macca448/Blynk2MESH/assets/blynk_pin_map.jpg

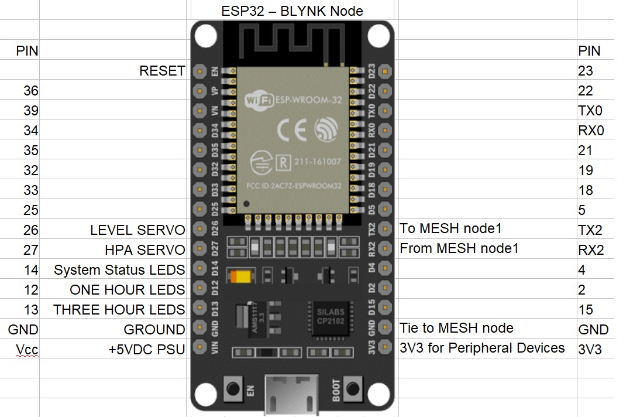
assets/blynk_pin_map.jpg
