macca448/Blynk2MESH/assets/garage_pin_map.jpg

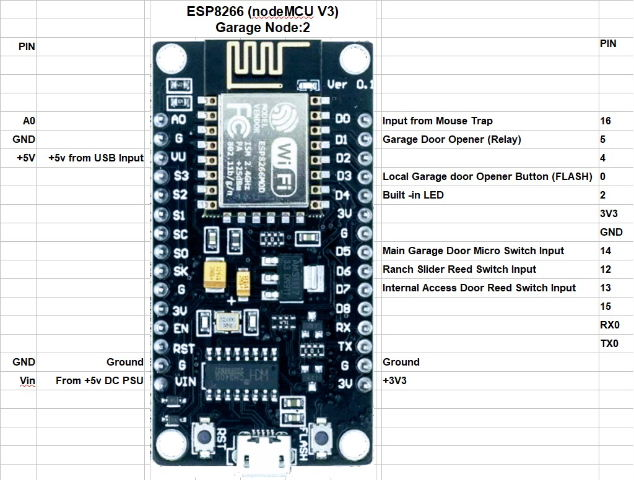
assets/garage_pin_map.jpg
