macca448/Blynk2MESH/assets/kitchen_pin_map.jpg

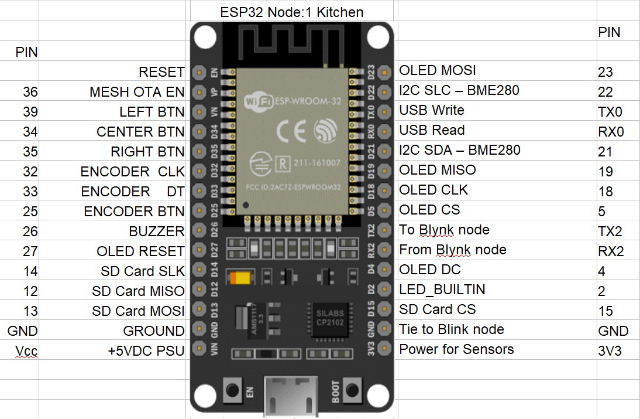
assets/kitchen_pin_map.jpg
