macca448/Blynk2MESH/assets/mouse_trap_circuit.png

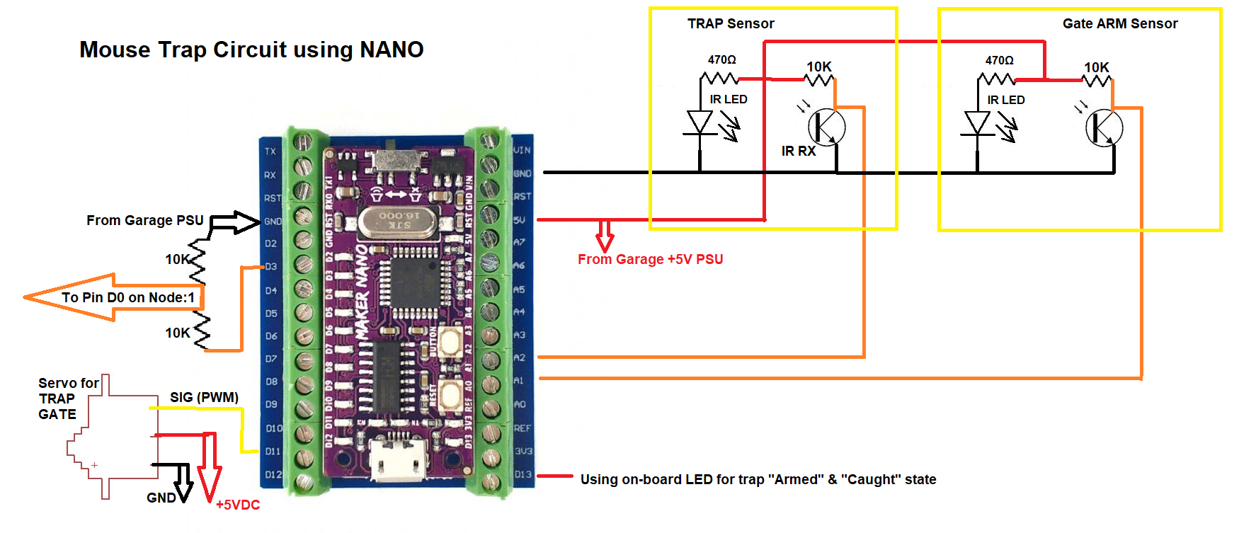
assets/mouse_trap_circuit.png
