macca448/Blynk2MESH/assets/bom_&_pin_assignments.xls

Sheet: BoM
BLYNK 2 MESH Bill-of-Materials (BoM)
Item | Part # | Qty | Description
1 | ESP32 | 3 | for Blynk, Node1 and Node4
2 | ESP8266 | 2 | Fo rNode 2 and 3
3 | PSU | 2 | 1A wall Wart for Nodes 2 and 3
4 | PSU | 2 | 2A Wall warts for Nodes1/Blynk and Node 4
5 | SSD1306 | 1 | 2.4” OLED
6 | Encoder | 1 | Rotary Encoder
7 | Buttons | 3 | Momentay Buttons
8 | Switch | 1 | Slide Switch
9 | Buzzer | 1 | Buzzer
10 | SD Card | 1 | SD card Reader
11 | BMP280 | 1 | BMP280 Sensor
12 | LED Strip | 3 | 8bit Addressable LED Strip
13 | Servo | 2 | Minature servo for analog gauges
14 | Relay | 1 | Relay Module for Garage door Open Close
15 | Micro Sw | 1 | Micro Switch for garage Door state
16 | REED Sw | 2 | magnetic Reed switches for Ranch and Internal Garage Doors
17 | NANO | 1 | For Mouse Trap
18 | IR Emitter | 2 | IR Emitters for Mouse Trap
19 | IR RX | 2 | Photodiodes for Mouse Trap
20 | Servo | 1 | Mouse Trap Gate Servo
21 | Combo | 1 | ATX and BMP Combo Weather Sensor for Tank1
22 | JSN-SR04T | 1 | Waterproof Ultrasonic Sensor
23 | DS18b20 | 1 | Waterproof Tank Temp Sensor
24 | Relay | 1 | Relay Module for Yard Lights
25 | Current1 | 2 | 30A Curent Transformer
26 | Current2 | 1 | 5A Current Transformer
27 | AC Mon | 1 | AC Voltage Detection Module
28 | Hi-Torque | 1 | 20Kg Hi-Torque Servo
29 | 10K | 12
30 | 470R | 2
31 | 4.7K | 2
32 | Misc |  | Wire, Vero boards, connectors etc for each node
33 | 3D |  | 3D Printed Gears, Mounts and LED difusers

Sheet: Blynk Kitchen
 |  | ESP32 – BLYNK Node
PIN |  |  |  | PIN
 | RESET |  |  | 23
36 |  |  |  | 22
39 |  |  |  | TX0
34 |  |  |  | RX0
35 |  |  |  | 21
32 |  |  |  | 19
33 |  |  |  | 18
25 |  |  |  | 5
26 | LEVEL SERVO |  | To MESH node1 | TX2
27 | HPA SERVO |  | From MESH node1 | RX2
14 | System Status LEDS |  |  | 4
12 | ONE HOUR LEDS |  |  | 2
13 | THREE HOUR LEDS |  |  | 15
GND | GROUND |  | Tie to MESH node | GND
Vcc | +5VDC PSU |  | 3V3 for Peripheral Devices | 3V3

Sheet: ESP32 Kitchen Node1
 |  | ESP32 Node:1 Kitchen
 |  |  |  | PIN
PIN
 | RESET |  | OLED MOSI | 23
36 | MESH OTA EN |  | I2C SLC – BME280 | 22
39 | LEFT BTN |  | USB Write | TX0
34 | CENTER BTN |  | USB Read | RX0
35 | RIGHT BTN |  | I2C SDA – BME280 | 21
32 | ENCODER CLK |  | OLED MISO | 19
33 | ENCODER DT |  | OLED CLK | 18
25 | ENCODER BTN |  | OLED CS | 5
26 | BUZZER |  | To Blynk node | TX2
27 | OLED RESET |  | From Blynk node | RX2
14 | SD Card SLK |  | OLED DC | 4
12 | SD Card MISO |  | LED_BUILTIN | 2
13 | SD Card MOSI |  | SD Card CS | 15
GND | GROUND |  | Tie to Blink node | GND
Vcc | +5VDC PSU |  | Power for Sensors | 3V3

Sheet: ESP8266 Garage Node2
 |  | ESP8266 (nodeMCU V3) Garage Node:2
PIN |  |  |  | PIN
A0 |  |  | Input from Mouse Trap | 16
GND |  |  | Garage Door Opener (Relay) | 5
+5V | +5v from USB Input |  |  | 4
 |  |  | Local Garage door Opener Button (FLASH) | 0
 |  |  | Built -in LED | 2
 |  |  |  | 3V3
 |  |  |  | GND
 |  |  | Main Garage Door Micro Switch Input | 14
 |  |  | Ranch Slider Reed Switch Input | 12
 |  |  | Internal Access Door Reed Switch Input | 13
 |  |  |  | 15
 |  |  |  | RX0
 |  |  |  | TX0
GND | Ground |  | Ground
Vin | From +5v DC PSU |  | +3V3

Sheet: ESP8266 Tank1 Node3
 |  | ESP8266 (nodeMCU V3) Water Tank Node:3
PIN |  |  |  | PIN
A0 |  |  |  | 16
GND |  |  | I2C Clock for Weather Sensors | SCL
+5V | +5v from USB Input |  | I2C Data for Weather Sensors | SDA
 |  |  |  | 0
 |  |  | Built-in LED | 2
 |  |  |  | 3V3
 |  |  |  | GND
 |  |  | One-Wire Dallas Buss for Tank Temp | 14
 |  |  | Ultrasonic Trigger | 12
 |  |  | Ultrasonic Echo | 13
 |  |  | Relay Logic for Yard Lights | 15
GND | Ground |  | Ground
Vin | From +5v DC PSU |  | +3V3

Sheet: ESP32 Septic Node4
 |  | ESP32 – Node:4 Septic System
PIN |  |  |  | PIN
 | RESET |  |  | 23
36 | Analog Input AC Current Level Bulb |  | PWM for By-pass Servo | 22
39 | Analog Input AC Current Pump 1 |  |  | TX0
34 | Analog Input AC Current Pump 2 |  |  | RX0
35 |  |  |  | 21
32 |  |  |  | 19
33 |  |  |  | 18
25 |  |  |  | 5
26 |  |  |  | TX2
27 |  |  |  | RX2
14 |  |  |  | 4
12 | AC Monitor Level Alarm (Active LOW) |  |  | 2
13 |  |  |  | 15
GND | GROUND |  |  | GND
Vcc | +5VDC PSU |  | Power for Sensors / Logic | 3V3
