macca448/Blynk2MESH/learning/blynk_tank_node/wiring.png

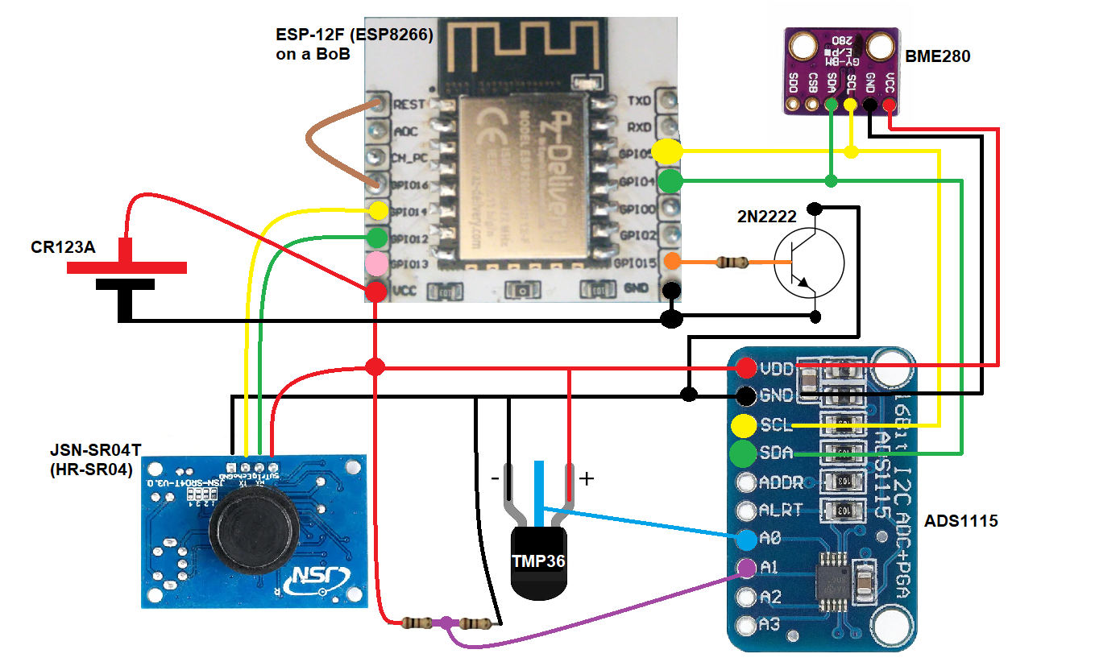
learning/blynk_tank_node/wiring.png
