macca448/Blynk2MESH/current/mouse_trap/mouse_trap.ino

//A simplistic first build
//Both trap design and this sketch need more work and fine tuning
//Working Prototype on an ATTiny85
//Set bootloader clock to "internal 8Mhz"
//Tested with the Simple ATTiny25/45/85 controller library
//Circuit Schematic https://raw.githubusercontent.com/macca448/Blynk2MESH/main/assets/mouse_trap_schematic.jpg

//8bit Servo library for ATTiny85         >> https://github.com/fri000/Servo8Bit
#include "Servo8Bit.h"                

//Input/Output pin constants

#define LED   PB0           //PB0 Pin 5     These are the ATTiny pins
#define SERVO PB1           //PB1 Pin 6
#define ENTRY A1            //PB2 Pin 7 A1
#define TRAP  A2            //PB4 Pin 3 A2
#define STATE PB3           //PB3 Pin 2
                            //PB5 Pin 1 = RESET Must be Pulled High
//Macro's
#define OPEN 160        
#define CLOSED 40
#define DUTY 500  
#define DELAY 4   

//Servo object
Servo8Bit servo;                      

//All the variables
uint32_t  previousTime = 0;       
bool      update = 0, watch = 0, armed = 0, ledState = 0, blink = 0, udServo = 0;
uint16_t  eReading, tReading, lastEreading, lastTreading;
uint8_t   pos = OPEN, timer1 = 0;

void setup(){
  pinMode(LED, OUTPUT);
  digitalWrite(LED, ledState);
  pinMode(STATE, OUTPUT);
  digitalWrite(STATE, ledState);
  servo.attach(SERVO);
  servo.write(pos);
  delay(3000);
  servo.detach();    
}

void loop (){

    if(millis() - previousTime >= DUTY){       //Half second loop duty period
        previousTime = millis();
        eReading = analogRead(ENTRY);
        tReading = analogRead(TRAP);

            if(eReading != lastEreading){
                if(eReading > 500 ){
                    ledState = HIGH;          //So we can see a mouse has entered the tunnel
                    update = true;
                    watch = true;             //Arm the Trap
                }
            }

            if(watch){
                  if(tReading != lastTreading){
                      if(tReading > 500){          //Mouse now entering main chamber of trap
                          servo.attach(SERVO);    //Get ready to close the trap door
                          servo.write(OPEN);
                          timer1 = 0;             //Reset a counter for a small delay
                          armed = true;
                      }
                  }
            }
            if(armed){
                if(tReading && eReading < 500 ){            //The mouse should now be in the main chamber                             
                    timer1++;
                }  
                if(timer1 >= DELAY && (tReading && eReading < 500 )){  //5 second delay and mouse must not back in the entry
                    pos = CLOSED;                   //Set servo position
                    digitalWrite(STATE, HIGH);      //This will update BLYNK about the capture
                    timer1 = 0;                     //Start new timer
                    udServo = true;                 //Update servo position
                    blink = true;                   //Blink the led to signal mouse in trap
                }
            }
            if(blink){
                ledState = !ledState;
                update = true;        
            }
            if(update){
                digitalWrite(LED, ledState);
                update = false;
            }
        lastEreading = eReading;
        lastTreading = tReading;
    }
    if(udServo){
        servo.write(pos);               //GOTYA you little varment!
            if(timer1 >= 6){
                armed = false;          //Disables loop Armed functions
                servo.detach();         //detach servo as hold torque not needed
                udServo = false;        //If we get here we have caught a mouse and the program ends till next restart
            }                           //Todo: Design a trap with multi chambers to catch more than one mouse.
    }
}
