macca448/Blynk2MESH/current/blynk2mesh/credentials.h

// You should get Auth Token in the Blynk App.
// Go to the Project Settings (nut icon).
#define BLYNK_TEMPLATE_ID "YOUR_ID"
#define BLYNK_TEMPLATE_NAME "YOUR_TEMPLATE"
#define BLYNK_AUTH_TOKEN "YOUR_TOKEN"

// Your WiFi credentials.
// Set password to "" for open networks.
const char* ssid = "Your_WiFi_SSID";
const char* pass = "Your_WiFi_Password";
