macca448/Blynk2MESH/(notices)

Notices in the files:
learning/ESPflash_array_config/ESPflash_array_config.ino:
This Arduino ESP sketch is free software: you can redistribute it and/or modify
it under the terms of the GNU General Public License as published by
the Free Software Foundation, either version 3 of the License, or
(at your option) any later version.
